stushar047/Digital-thermometer-using-PIC-microcontroller-and-thermistor/(list of files, drawings)

Other design files:
project.DSN
